lianghongkey/PressureSensor/BOM_Board1612_Schematic1_1_2023-10-09.xlsx

No. | Quantity | Comment | Designator | Footprint | Value | Manufacturer Part | Manufacturer | Supplier Part | Supplier | LCSC Price
1 | 7 | 22uF | C1,C4,C7,C9,C19,C28,C30 | R0603 | 22uF
2 | 15 | 10nF COG | C2,C5,C8,C11,C13,C20,C21,C22,C23,C24,C25,C29,C31,C32,C33 | R0603 | 10nF COG
3 | 8 | 1uF | C3,C16,C17,C18,C34,C35,C36,C37 | R0603 | 1uF
4 | 4 | 100p | C10,C12,C14,C15 | R0603 | 100p
5 | 2 | 100nF | C26,C27 | R0603 | 100nF
6 | 4 | HDGC2001WV-4P | CN1,CN2,CN3,CN4 | CONN-TH_4P-P2.00_HDGC_HDGC2001WV-4P |  | HDGC2001WV-4P | HDGC(华德共创) | C5175232 | LCSC
7 | 1 | HC-XHB-3A | CN5 | CONN-TH_3P-P2.50_HC-XHB-3A |  | HC-XHB-3A | HCTL(华灿天禄) | C2845491 | LCSC
8 | 2 | nSMD020-30V | F1,F2 | F1206 |  | nSMD020-30V | 台湾陆海 | C69680 | LCSC
9 | 1 | PZ254V-11-03P | H2 | HDR-TH_3P-P2.54-V-M |  | PZ254V-11-03P | XFCN(兴飞) | C2937625 | LCSC
10 | 4 | PZ254V-11-02P | H5,H6,H7,H8 | HDR-TH_2P-P2.54-V-M |  | PZ254V-11-02P | XFCN(兴飞) | C492401 | LCSC
11 | 2 | LED_0603-B | LED3,LED4 | LED_0603
12 | 1 | PH-3A | P1 | CONN-TH_12P-P2.00-H-W4.8_PH-3A |  | PH-3A | BOOMELE(博穆精密) | C2320 | LCSC
13 | 1 | S8050 | Q1 | SOT-23-3_L2.9-W1.6-P1.90-LS2.8-BR |  | S8050 | CJ(江苏长电/长晶) | C105433 | LCSC
14 | 17 | 2K | R2,R4,R7,R8,R9,R10,R12,R13,R14,R15,R16,R35,R37,R41,R43,R46,R47 | R0603 | 2K | ARG02BTC4R70 | Viking(光颉) |  | LCSC
15 | 3 | 15K | R3,R17,R18 | R0603 | 15K | ARG02BTC4R70 | Viking(光颉) |  | LCSC
16 | 4 | 50 | R5,R33,R38,R40 | RES-ADJ-TH_3P-L10.0-W10.0-P2.50-L | 50 | 3296W-1-103 | BOCHEN(博晨) |  | LCSC
17 | 4 | 50 | R6,R34,R39,R42 | R0603 | 50
18 | 4 | 120 | R11,R36,R44,R45 | R0603 | 120 | ARG02BTC4R70 | Viking(光颉) |  | LCSC
19 | 1 | 2.2K | R19 | R0603 | 2.2K | ARG02BTC4R70 | Viking(光颉) |  | LCSC
20 | 1 | 100K | R20 | R0603 | 100K | ARG02BTC4R70 | Viking(光颉) |  | LCSC
21 | 3 | 2.2K | R21,R22,R29 | R0603 | 2.2K
22 | 1 | 15K | R23 | R0603 | 15K
23 | 3 | 10K | R24,R31,R48 | R0603 | 10K
24 | 3 | 10K | R25,R26,R27 | RES-ADJ-TH_3P-L10.0-W10.0-P2.50-L | 10K | 3296W-1-103 | BOCHEN(博晨) |  | LCSC
25 | 2 | 5K | R28,R30 | R0603 | 5K
26 | 1 | ESDA5V3L | TV1 | SOT-23-3_L2.9-W1.6-P1.90-LS2.8-BR |  | ESDA5V3L | ST(意法半导体) | C87911 | LCSC
27 | 2 | LP5907MFX-4.5/NOPB | U1,U2 | TSOT-23-5_L2.9-W1.6-P0.95-LS2.8-BR |  | LP5907MFX-4.5/NOPB | TI(德州仪器) | C529554 | LCSC
28 | 2 | TLV2333IDGKR | U4,U5 | SOIC-8_L4.9-W3.9-P1.27-LS6.0-BL |  | TLV2333IDGKR | TI(德州仪器) | C527573 | LCSC
29 | 4 | OPA1612AIDRGR | U9,U10,U11,U12 | SON-8_L3.0-W3.0-P0.50-TL-EP_OPA1612AIDRGR |  | OPA1612AIDRGR | TI(德州仪器) | C2058640 | LCSC
