lianghongkey/PressureSensor/SCH_Schematic1_1_2023-10-08.pdf

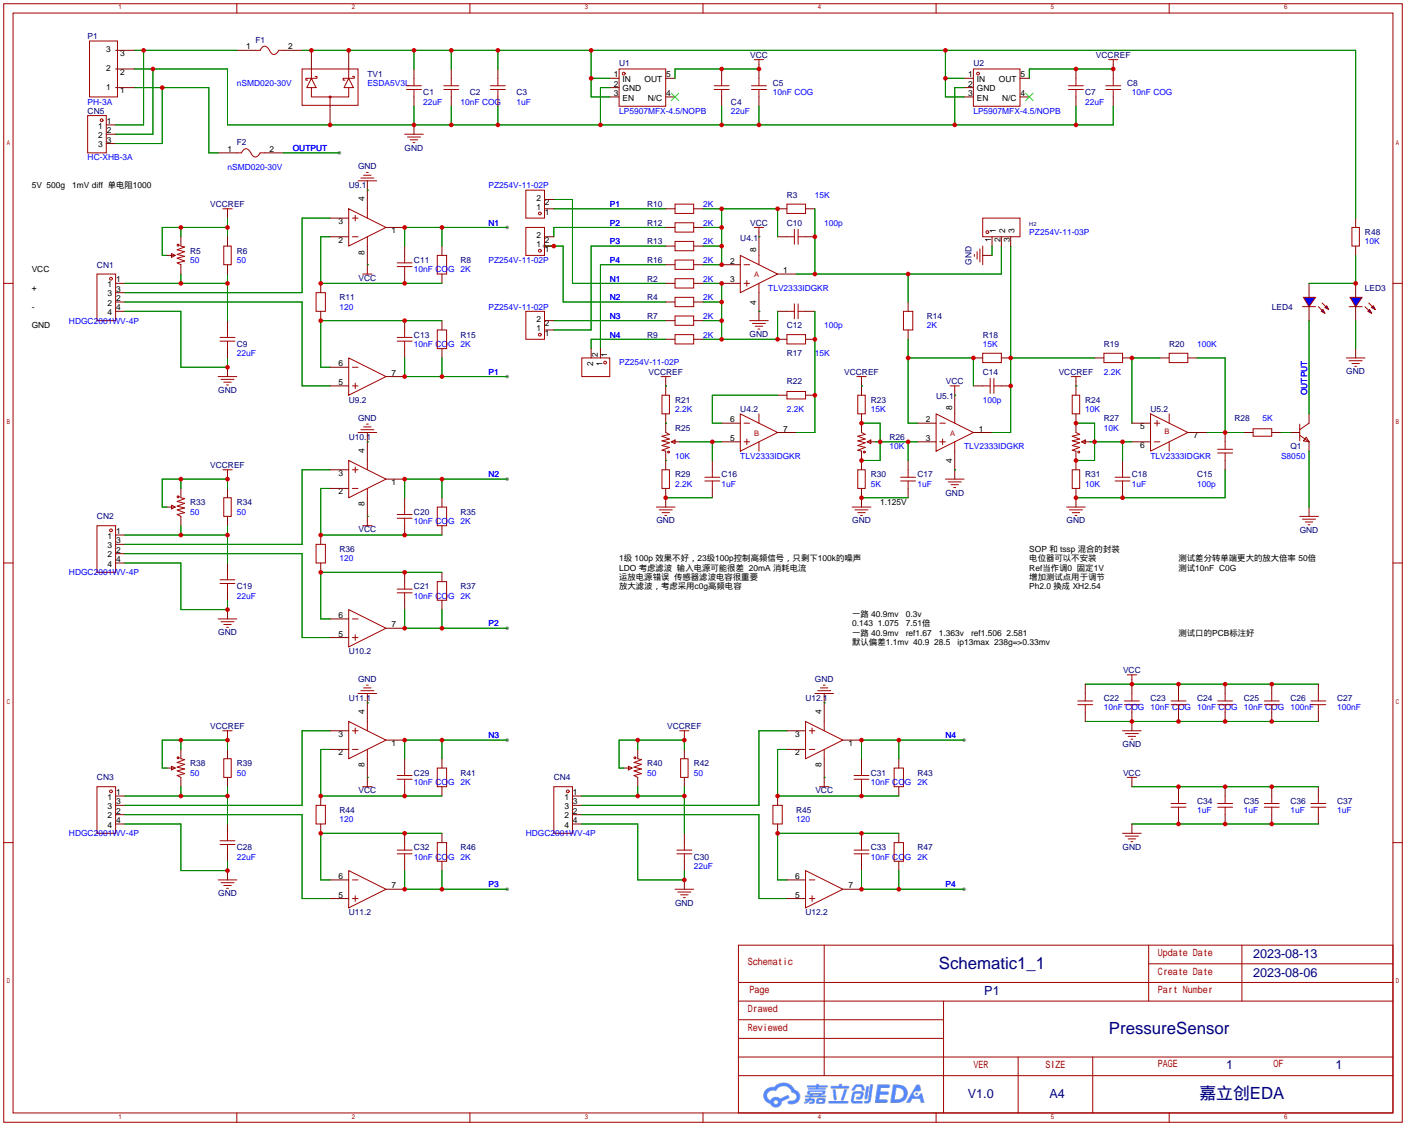
[picture p3: page 1]

1级 100p 效果不好，23级100p控制高频信号，只剩下100k的噪声
LDO 考虑滤波 输入电源可能很差 20mA 消耗电流
运放电源错误 传感器滤波电容很重要
放大滤波，考虑采用c0g高频电容
