lianghongkey/PressureSensor/(list of files, drawings)

Other design files:
lceda/ProDocument_Board1612_2023-10-08.epro
lceda/ProDocument_Schematic1_1_2023-10-08.epro
lceda/ProProject_PressureSensor_2023-10-08.epro
